wattwind/wattwind/hardware/docs/prices.md

# Price list (checked 2026-10-30)

Prices for one board, single quantities, EUR. Distributor prices change often and may exclude VAT and
shipping: check before ordering. USD prices converted at about 0.9. **Measured** = from a distributor listing on
2026-10-30; **est.** = typical distributor price, not checked item by item.

| Qty | Part | Each | Total | Source |
|---|---|---|---|---|
| 4 | Finder 34.51.7.005.0010 relay (SPDT, 5 V) | €8.40 | €33.60 | measured: Digi-Key €8.41, Conrad €8.49 incl. VAT; Bürklin €9.17 |
| 1 | Raspberry Pi Pico 2 WH (headers fitted) | €11.00 | €11.00 | measured: Conrad €10.99 incl. VAT (Pico 2 W without headers ~€7) |
| 1 | Mean Well IRM-02-5 | €4.80 | €4.80 | measured: TME $5.31, Digi-Key $5.30 |
| 1 | Toshiba TBD62003APG | €1.50 | €1.50 | measured: TME $1.04 ((Z,HZ) code), Mouser $1.90 |
| 1 | Fuse holder 5×20 (Schurter 0031.8201) | €0.80 | €0.80 | est. |
| 3 | Fuse T1A ceramic 5×20 (1 + 2 spares) | €0.50 | €1.50 | est. |
| 1 | Terminal 2-pos 5.08 mm (Phoenix MKDS 1,5/2) | €0.70 | €0.70 | est. |
| 1 | Terminal 4-pos 5.08 mm (Phoenix MKDS 1,5/4) | €1.40 | €1.40 | est. |
| 1 | 1N5819 | €0.10 | €0.10 | est. |
| 2 + 3 | 100 µF 16 V, 100 nF 50 V | €0.10 | €0.50 | est. |
| 1 | PCB (5 boards at a PCB maker, 65 × 82 mm) | €2 + shipping | €2–15 | est.: ~€2 for 5 boards; shipping €5–15 depending on speed |
| 1 | M16 × 1.5 cable gland | €1.00 | €1.00 | est. |
| ~1 m | 6 × 0.75 mm² cable (e.g. ÖLFLEX CLASSIC 110 6X0.75) | €3.00 | €3.00 | est. |
| 7 + 7 | M3 heat-set inserts, M3 screws | | €2.00 | est. |
| ~60 g | Filament (flame-retardant, V-0) | €0.06/g | €3.50 | est.; FR filament costs €40–70 per kg |
| | **Total, one fan** | | **about €70–80** | the four relays are almost half of it |

Not included: tools, ferrules / lever connectors you may already have, and the fan itself. Parts for more boards
cost less each (the PCB order already gives five boards). Sources: [Digi-Key](https://www.digikey.com/en/products/detail/finder-relays-inc/34-51-7-005-0010/10822677),
[Conrad relay](https://www.conrad.com/en/p/502853.html), [Bürklin](https://www.buerklin.com/en/p/finder/industrial-relays/34-51-7-005-0010/29G9520/),
[Conrad Pico 2 WH](https://www.conrad.com/en/p/raspberry-pi-pico-2-wh-microcontroller-pico-2-wh-3415096.html),
[TME IRM-02-5](https://www.tme.eu/en/details/irm-02-5/pcb-ac-dc-converters/mean-well/),
[Mouser TBD62003APG](https://www.mouser.com/en/ProductDetail/Toshiba/TBD62003APG?qs=fSnNYG2PaKJOVh9%2FBibgZw%3D%3D).
