wattwind/wattwind/docs/img/photo-box-on-fan.jpg

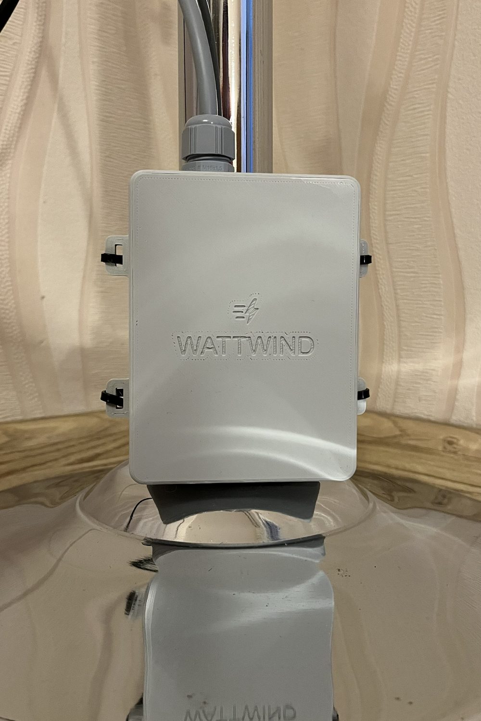
docs/img/photo-box-on-fan.jpg
