wattwind/wattwind/docs/img/ui-help.png

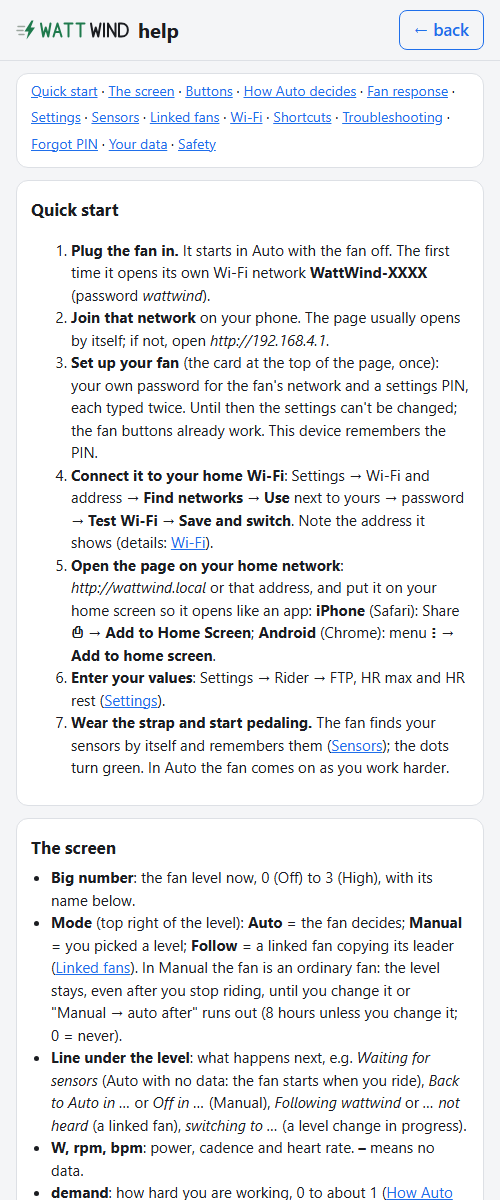
docs/img/ui-help.png
