wattwind/wattwind/docs/img/ui-home-screen.jpg

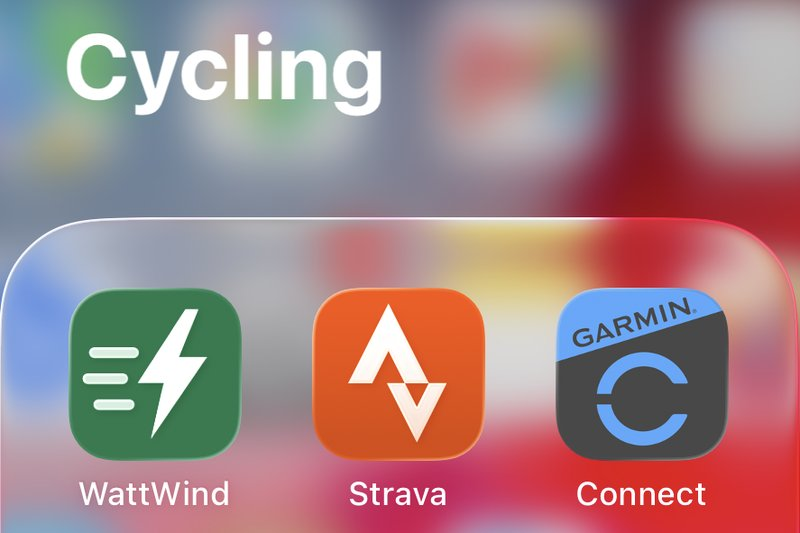
docs/img/ui-home-screen.jpg
