wattwind/wattwind/docs/img/ui-settings.png

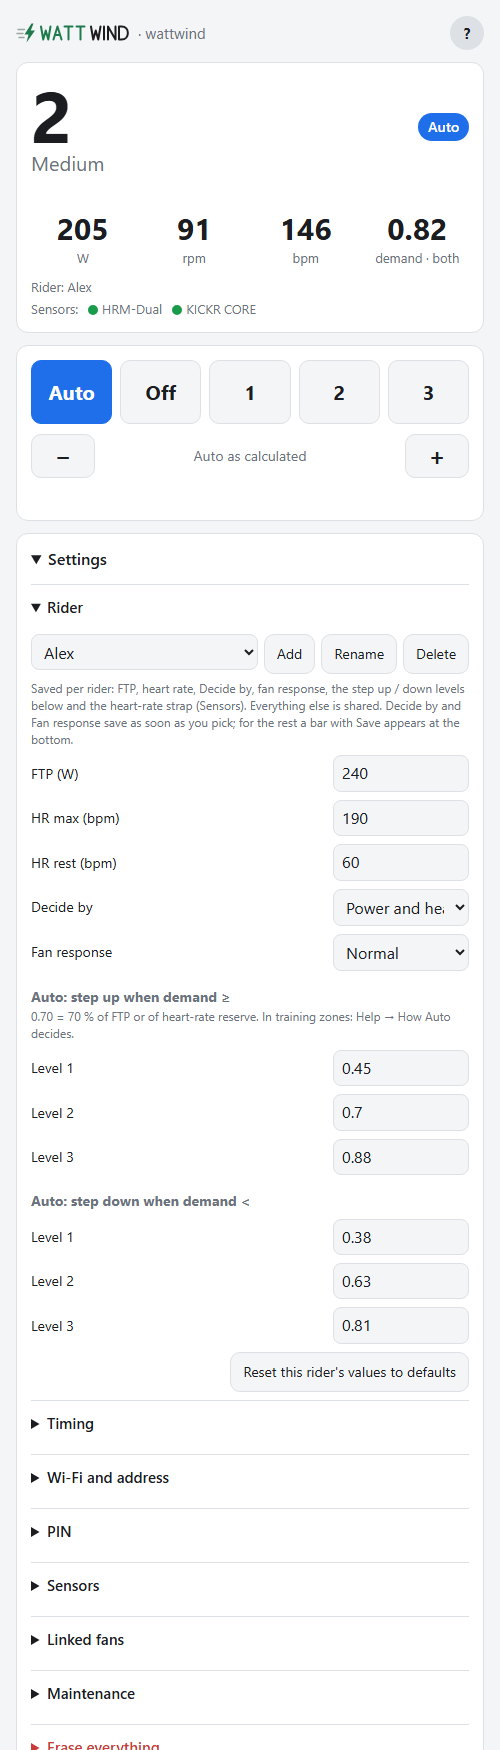
docs/img/ui-settings.png
