wattwind/wattwind/hardware/enclosure/WattWindEnclosureV2/renders/v2-lid-under.png

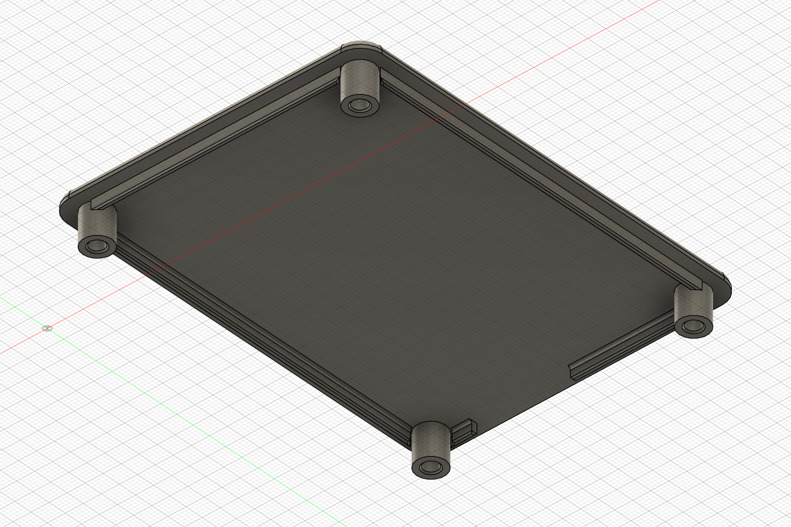
hardware/enclosure/WattWindEnclosureV2/renders/v2-lid-under.png
