wattwind/wattwind/hardware/img/bottom.png

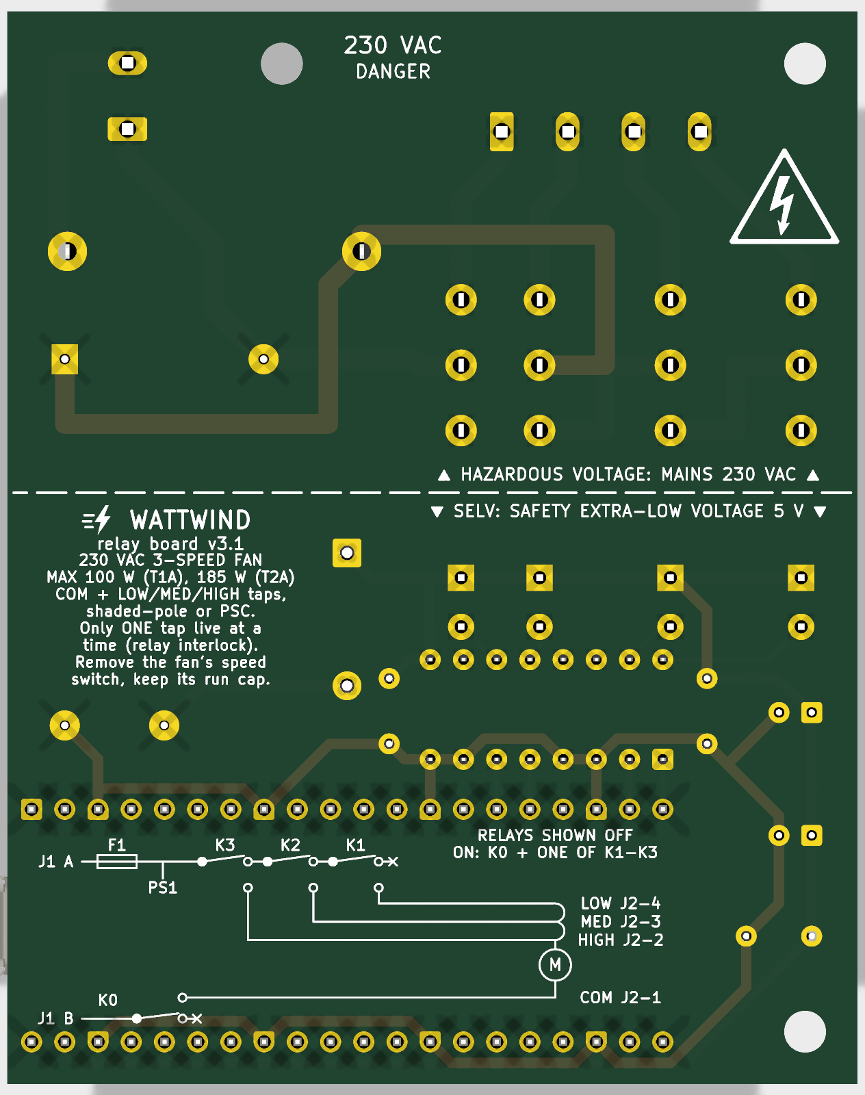
hardware/img/bottom.png
