wattwind/wattwind/hardware/3dmodels/Relay_SPDT_Finder_34.51_Vertical_White.step

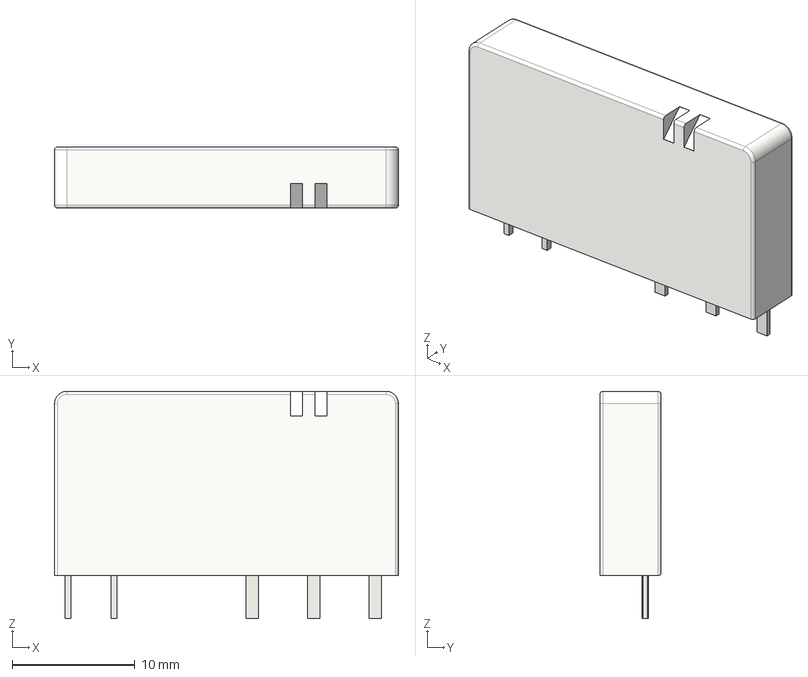
[picture p10: CAD file, 2026-11-02]
hardware/3dmodels/Relay_SPDT_Finder_34.51_Vertical_White.step
28.0 x 5.00 x 18.5 mm
