wattwind/wattwind/hardware/production/wattwind.step

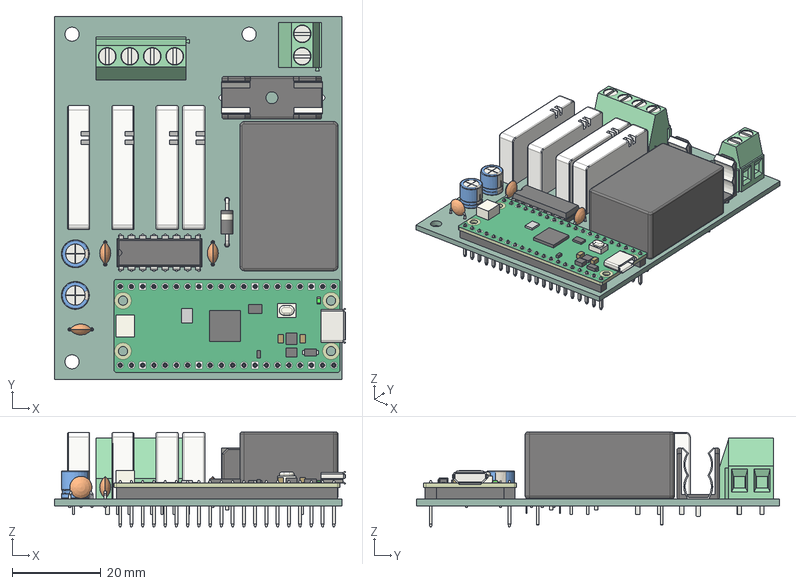
[picture p11: CAD file, 2026-11-02]
hardware/production/wattwind.step
65.8 x 82.0 x 21.4 mm
TerminalBlock_Phoenix_MKDS-1,5-2-5.08_1x02_P5.08mm_Horizontal
CP_Radial_D63mm_P250mm x 2
Relay_SPDT_Finder_34.51_Vertical x 4
Converter_ACDC_MeanWell_IRM_02_xx_THT
C_Disc_D50mm_W25mm_P500mm x 3
TerminalBlock_Phoenix_MKDS-1,5-4-5.08_1x04_P5.08mm_Horizontal
A_Schurter_0031_8201
D_DO-41_SOD81_P10.16mm_Horizontal
RaspberryPi_Pico_H_Module_KiCad
RaspberryPi_Pico_Header_DIP-40_H2.54mm_KiCad
DIP-16_W7.62mm
wattwind_PCB
