wattwind/wattwind/docs/img/demo-manual.jpg

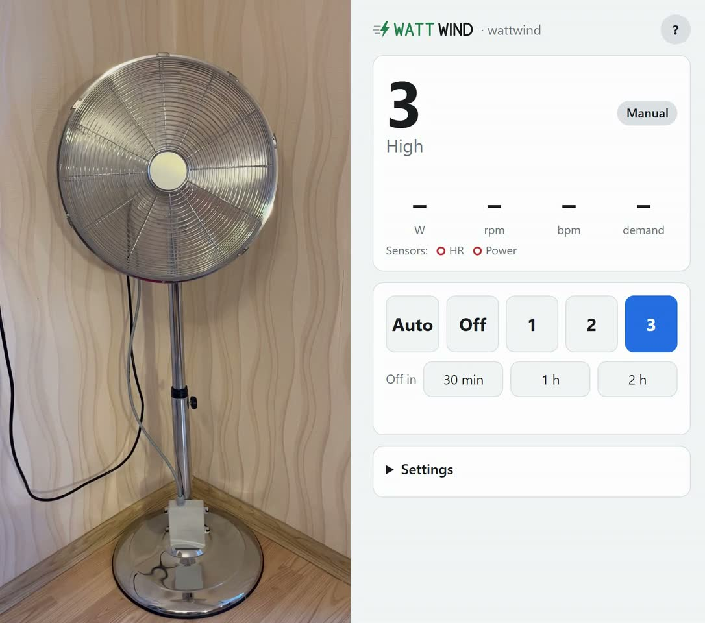
docs/img/demo-manual.jpg
