wattwind/wattwind/hardware/wattwind.kicad_pcb

## KiCad design hardware/wattwind.kicad_pcb (2026-11-02)

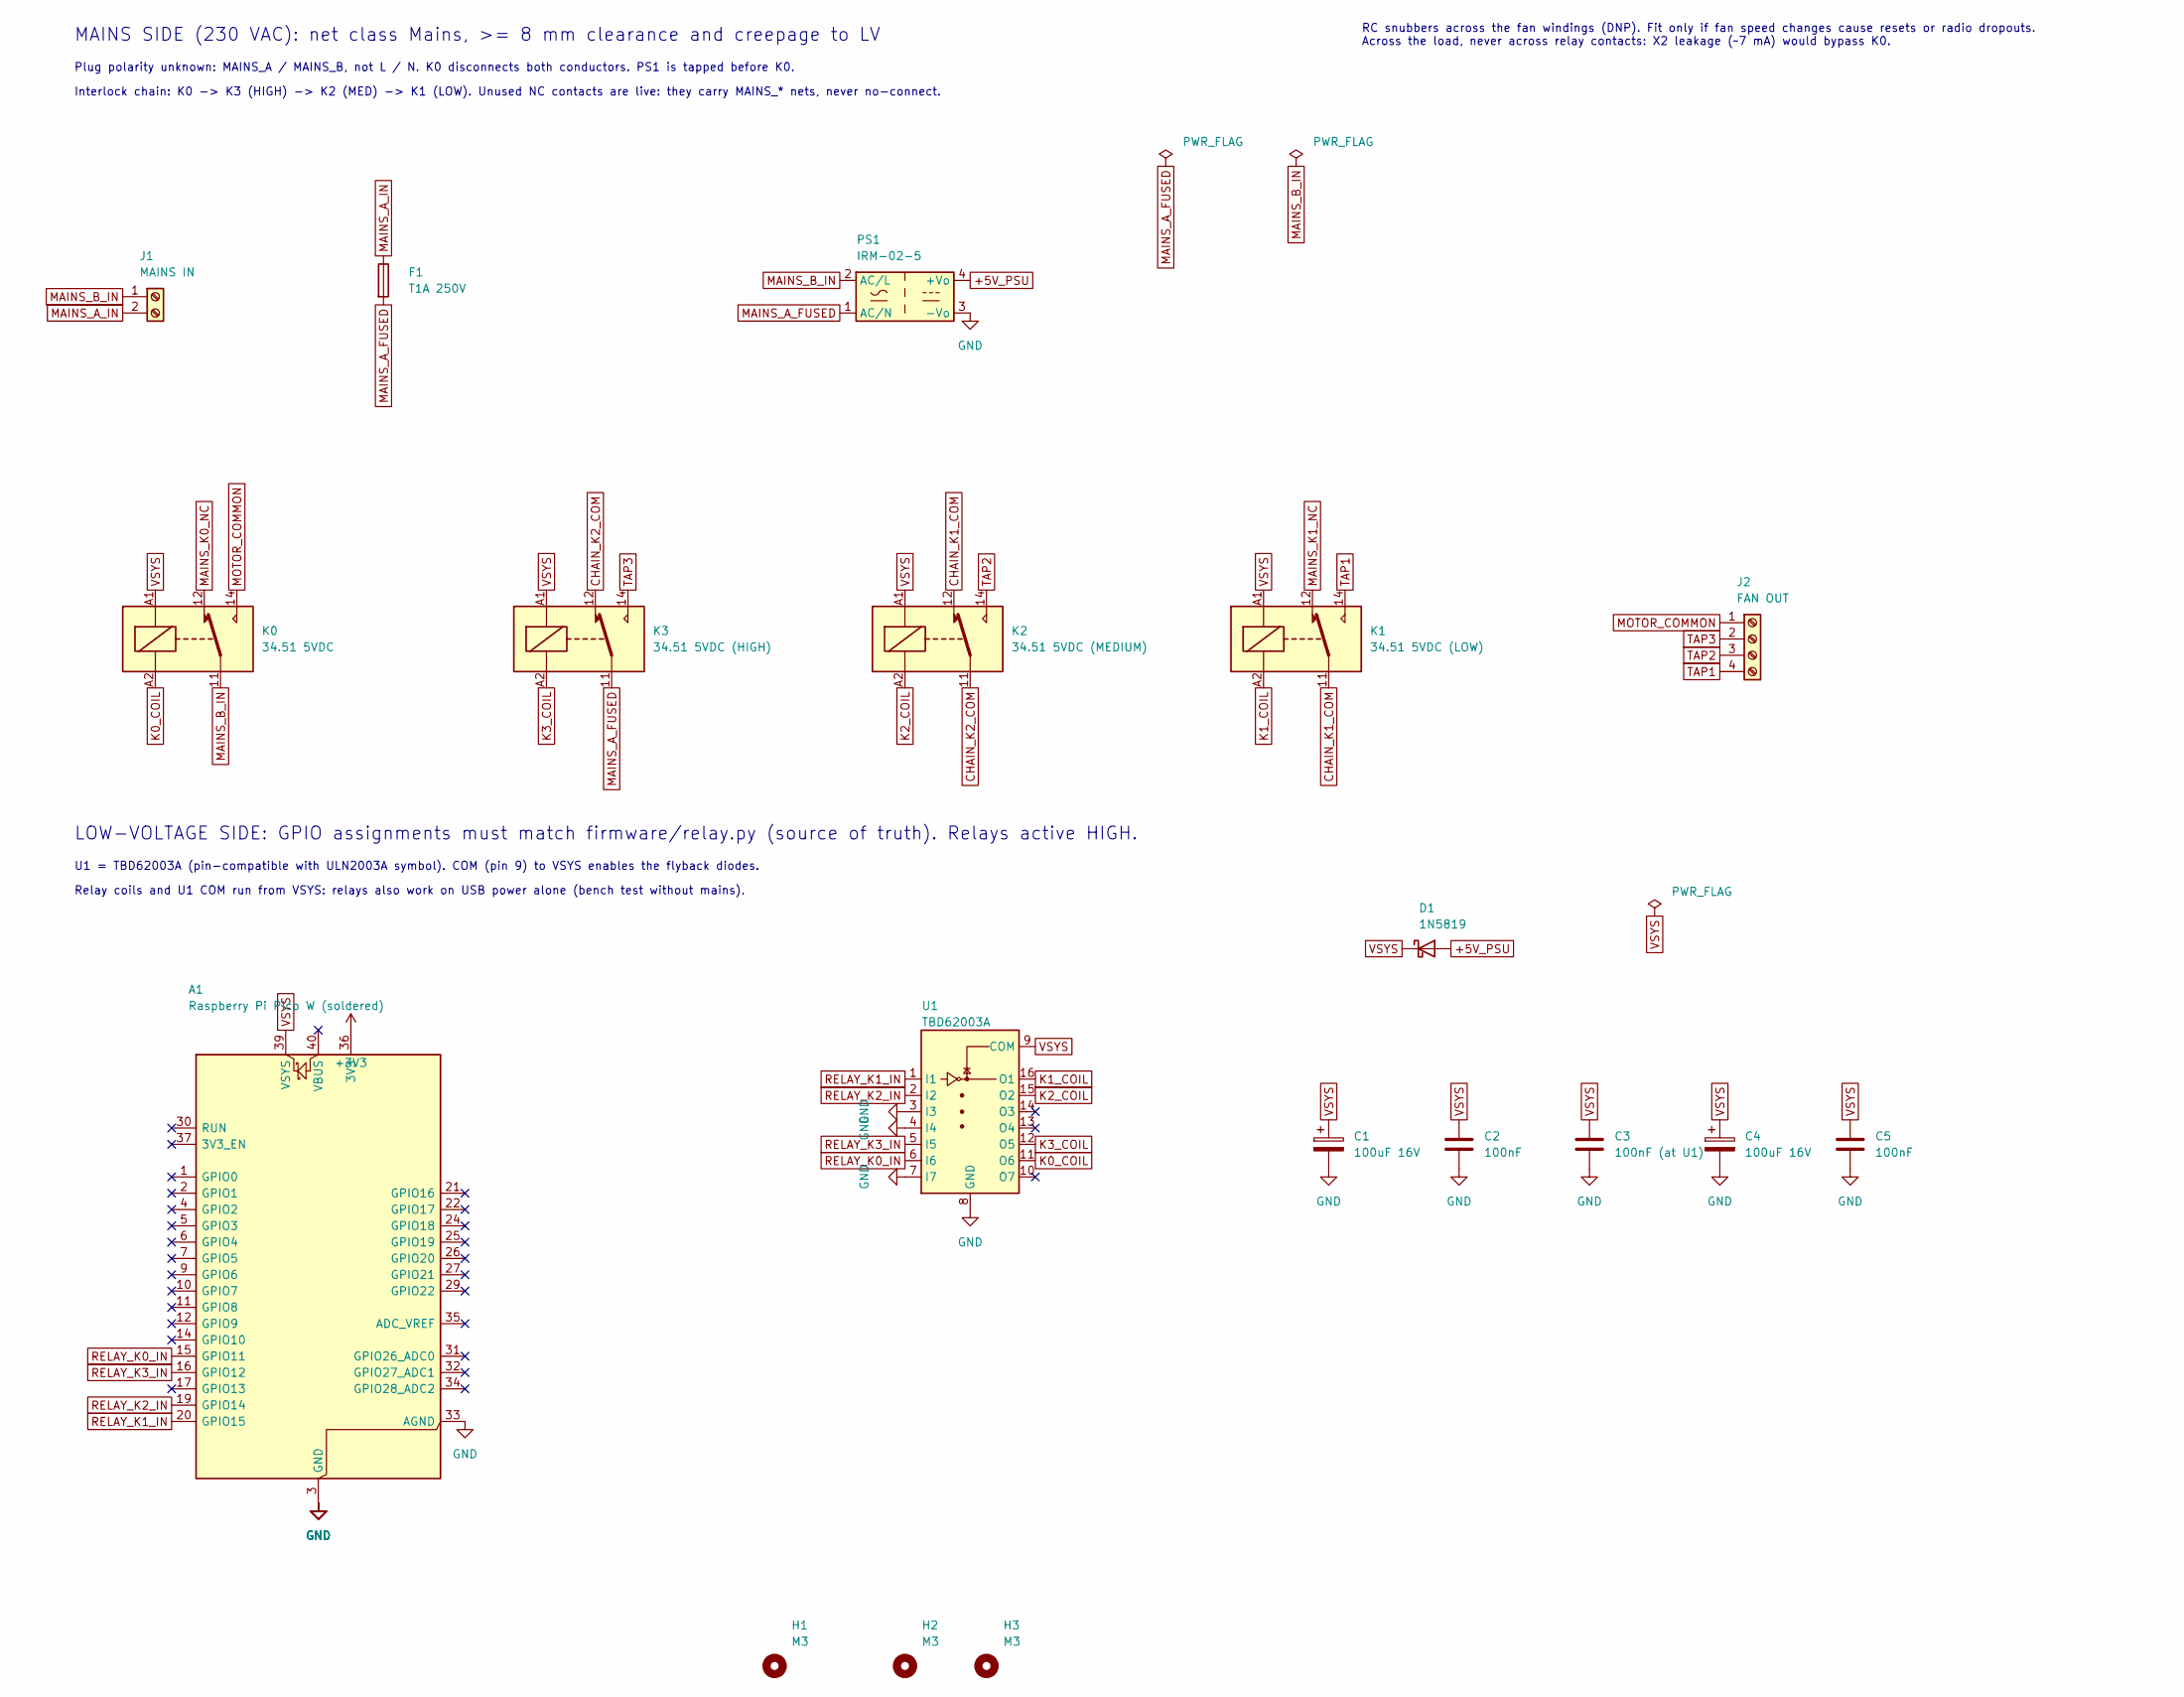
[picture p28: schematic wattwind.kicad_sch, WattWind relay board]

Parts:
A1: Raspberry Pi Pico W (soldered); RaspberryPi_Pico_Common_THT; MPN Pico W + 2x 1x20 female header 2.54 mm
C1, C4: 100uF 16V; CP_Radial_D6.3mm_P2.50mm; MPN 100uF 16V electrolytic, D6.3 mm, P2.5 mm
C2, C5: 100nF; C_Disc_D5.0mm_W2.5mm_P5.00mm; MPN 100nF 50V X7R ceramic, 5.0 mm pitch
C3: 100nF (at U1); C_Disc_D5.0mm_W2.5mm_P5.00mm; MPN 100nF 50V X7R ceramic, 5.0 mm pitch
D1: 1N5819; D_DO-41_SOD81_P10.16mm_Horizontal; MPN 1N5819
F1: T1A 250V; Fuseholder_Cylinder-5x20mm_Schurter_0031_8201_Horizontal_Op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; MPN 0031.8201 holder + fuse 5x20 mm T1A 250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
H1, H2, H3: M3; MountingHole_3.2mm_M3
J1: MAINS IN; TerminalBlock_Universal_1x02_P5.04mm_5.0-5.08; MPN MKDS 1,5/2-5,08 (1715721)
J2: FAN OUT; TerminalBlock_Universal_1x04_P5.04mm_5.0-5.08; MPN MKDS 1,5/4-5,08 (1715747)
K0: 34.51 5VDC; Relay_SPDT_Finder_34.51_Vertical; MPN 34.51.7.005.0010
K1: 34.51 5VDC (LOW); Relay_SPDT_Finder_34.51_Vertical; MPN 34.51.7.005.0010
K2: 34.51 5VDC (MEDIUM); Relay_SPDT_Finder_34.51_Vertical; MPN 34.51.7.005.0010
K3: 34.51 5VDC (HIGH); Relay_SPDT_Finder_34.51_Vertical; MPN 34.51.7.005.0010
PS1: IRM-02-5; Converter_ACDC_MeanWell_IRM-02-xx_THT; MPN IRM-02-5
U1: TBD62003A; DIP-16_W7.62mm; MPN TBD62003APG (DIP-16)

Connections:
+3V3: A1.36 (3V3)
+5V_PSU: D1.2 (A), PS1.4 (+Vo)
CHAIN_K1_COM: K1.11, K2.12
CHAIN_K2_COM: K2.11, K3.12
GND: A1.3 (GND), A1.8 (GND), A1.13 (GND), A1.18 (GND), A1.23 (GND), A1.28 (GND), A1.33 (AGND), A1.38 (GND), C1.2, C2.2, C3.2, C4.2, C5.2, PS1.3 (-Vo), U1.3 (I3), U1.4 (I4), U1.7 (I7), U1.8 (GND)
K0_COIL: K0.A2, U1.11 (O6)
K1_COIL: K1.A2, U1.16 (O1)
K2_COIL: K2.A2, U1.15 (O2)
K3_COIL: K3.A2, U1.12 (O5)
MAINS_A_FUSED: F1.2, K3.11, PS1.1 (AC/N)
MAINS_A_IN: F1.1, J1.2
MAINS_B_IN: J1.1, K0.11, PS1.2 (AC/L)
MAINS_K0_NC: K0.12
MAINS_K1_NC: K1.12
MOTOR_COMMON: J2.1, K0.14
RELAY_K0_IN: A1.15 (GPIO11), U1.6 (I6)
RELAY_K1_IN: A1.20 (GPIO15), U1.1 (I1)
RELAY_K2_IN: A1.19 (GPIO14), U1.2 (I2)
RELAY_K3_IN: A1.16 (GPIO12), U1.5 (I5)
TAP1: J2.4, K1.14
TAP2: J2.3, K2.14
TAP3: J2.2, K3.14
VSYS: A1.39 (VSYS), C1.1, C2.1, C3.1, C4.1, C5.1, D1.1 (K), K0.A1, K1.A1, K2.A1, K3.A1, U1.9 (COM)

Notes on the sheet:
Plug polarity unknown: MAINS_A / MAINS_B, not L / N. K0 disconnects both conductors. PS1 is tapped before K0.
RC snubbers across the fan windings (DNP). Fit only if fan speed changes cause resets or radio dropouts. Across the load, never across relay contacts: X2 leakage (~7 mA) would bypass K0.
Interlock chain: K0 -> K3 (HIGH) -> K2 (MED) -> K1 (LOW). Unused NC contacts are live: they carry MAINS_* nets, never no-connect.
LOW-VOLTAGE SIDE: GPIO assignments must match firmware/relay.py (source of truth). Relays active HIGH.
U1 = TBD62003A (pin-compatible with ULN2003A symbol). COM (pin 9) to VSYS enables the flyback diodes.
Relay coils and U1 COM run from VSYS: relays also work on USB power alone (bench test without mains).
MAINS SIDE (230 VAC): net class Mains, >= 8 mm clearance and creepage to LV

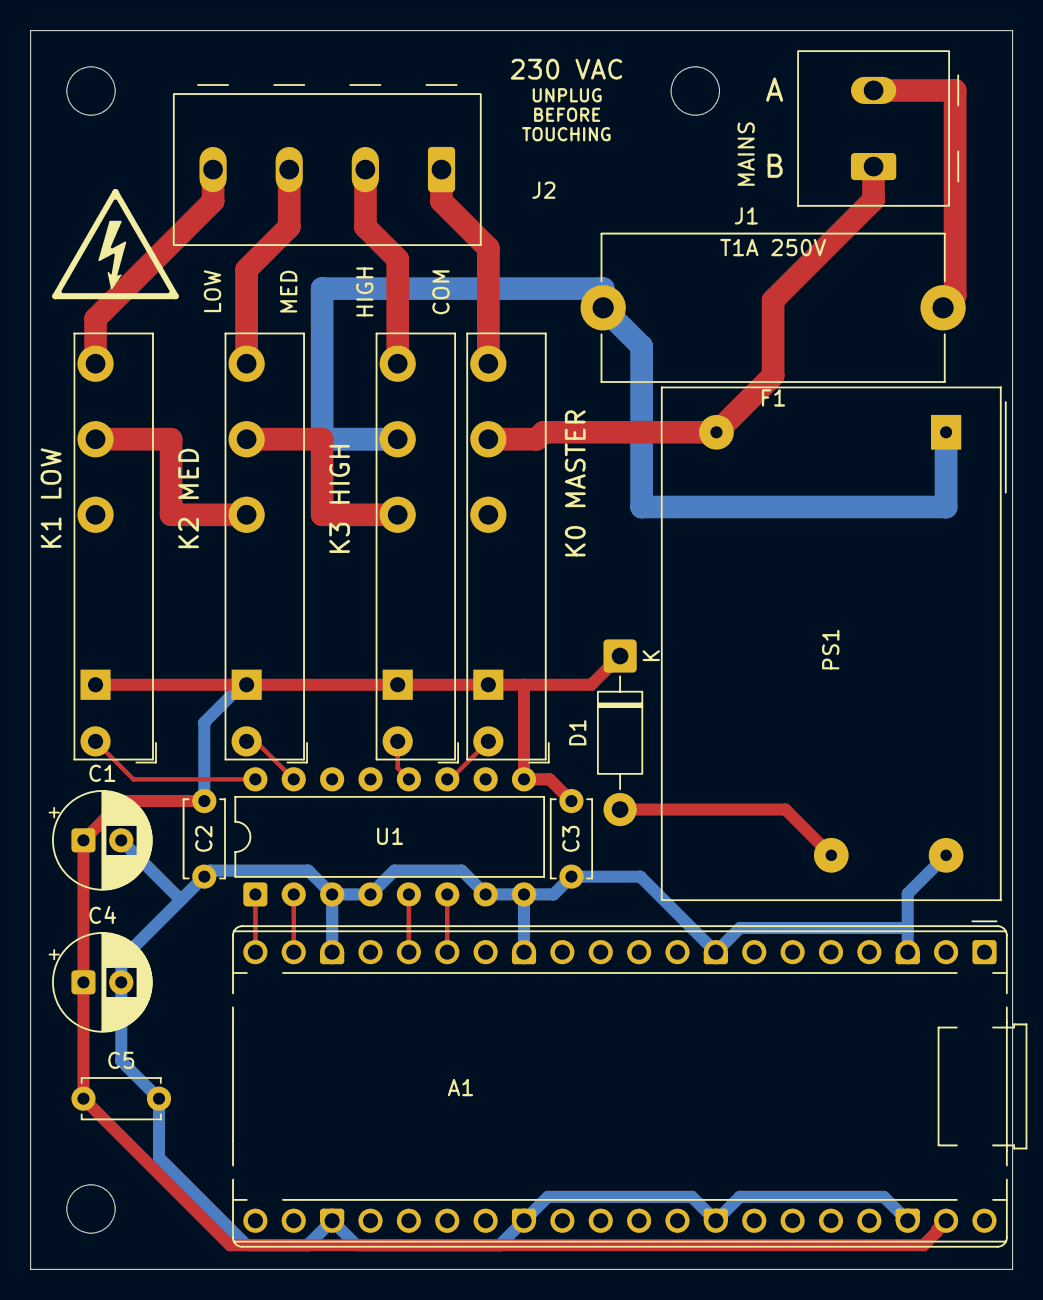
[picture p29: board wattwind.kicad_pcb from above]

Board: 2 copper layers, 65.0 x 82.0 mm, 21 parts (1 on the bottom side), 20 nets.

Other parts of the board:
G1, G2: Symbol_HighVoltage_Triangle_8x7mm_SilkScreen
