wattwind/wattwind/firmware/release_key.py

"""The public key of whoever makes this firmware's releases (tools/make_keys.py). Wi-Fi updates must be
signed with the matching private key (updater.verified_manifest). Public: safe to publish."""
KEY = "8d978fd1695509d89b9b8f9a772616cc5b733c27eb4b578d2afd3694ddf2f738"
