wattwind/wattwind/(commit log)

2026-11-02 WattWind 1.0.0: automatic trainer fan (firmware 1.0.0, relay board v3.1, enclosure V2, site and manual)
    [Relay_SPDT_Finder_34.51_Vertical_White.step, wattwind.kicad_pcb, wattwind.kicad_sch, wattwind.step]
2026-11-02 Site: try the page in your browser (docs/demo.html)
    The fan's own page with a pretend fan: a made-up rider on a sped-up workout, every button and setting working on the page, Auto decided by a JavaScript copy of the fan's logic. Linked from the main page, the features page and the README.
2026-11-02 Site: 'Signed updates over Wi-Fi' instead of 'Only official firmware' (USB stays open; switching makers explained)
